Hardware7253/LM3478-Boost-Dev-Board/README.md

# LM3478 Boost Dev Board
A dev board for an LM3478 controlled boost converter

Contains two python calculators for selecting appropriate main components and compensation components

## PCB
PCB
