Hardware7253/LM3478-Boost-Dev-Board/3D/SCDS105R.step

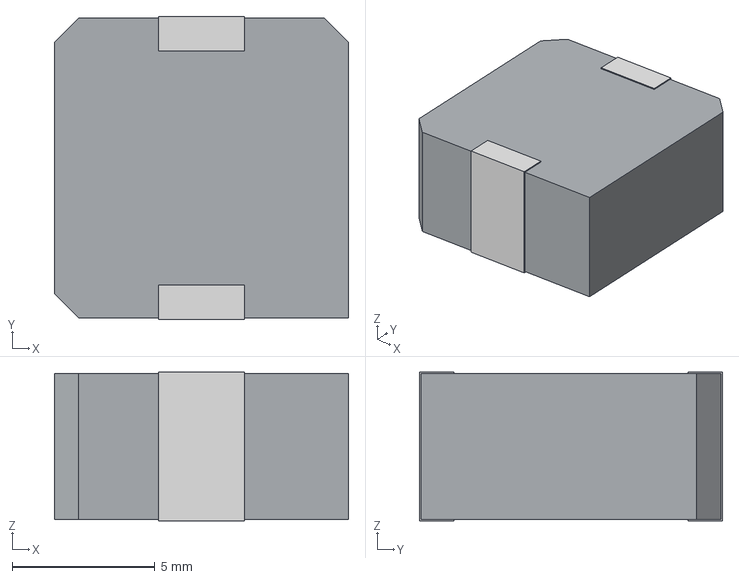
[picture p1: CAD file, 2025-11-23]
3D/SCDS105R.step
10.3 x 10.6 x 5.20 mm
