Hardware7253/LM3478-Boost-Dev-Board/3D/TestPoint_Keystone_5019_Minature.step

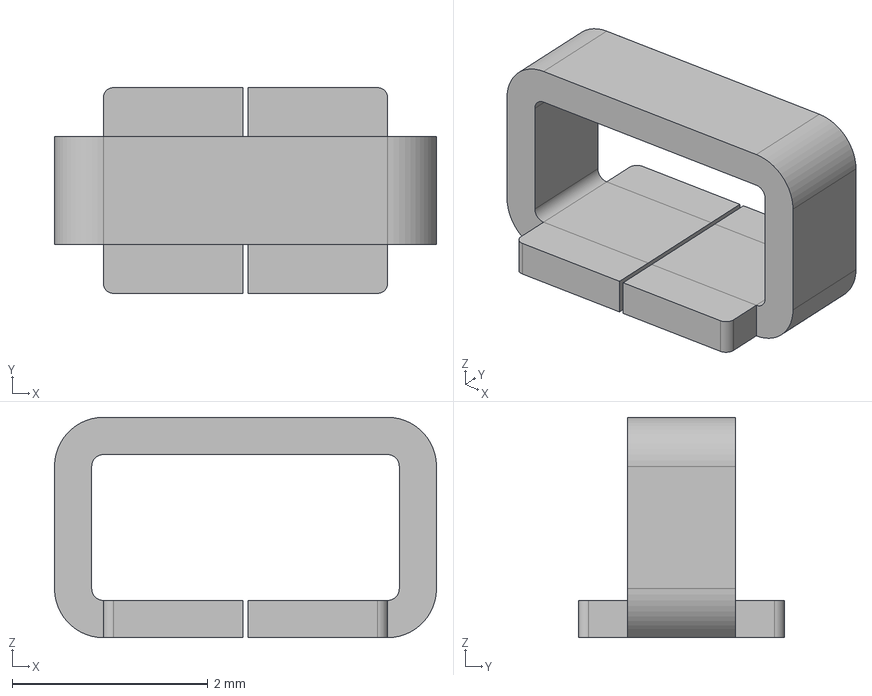
[picture p3: CAD file, 2025-11-23]
3D/TestPoint_Keystone_5019_Minature.step
3.90 x 2.10 x 2.25 mm
