Hardware7253/LM3478-Boost-Dev-Board/boost.kicad_pcb

## KiCad design boost.kicad_pcb (2025-11-28)

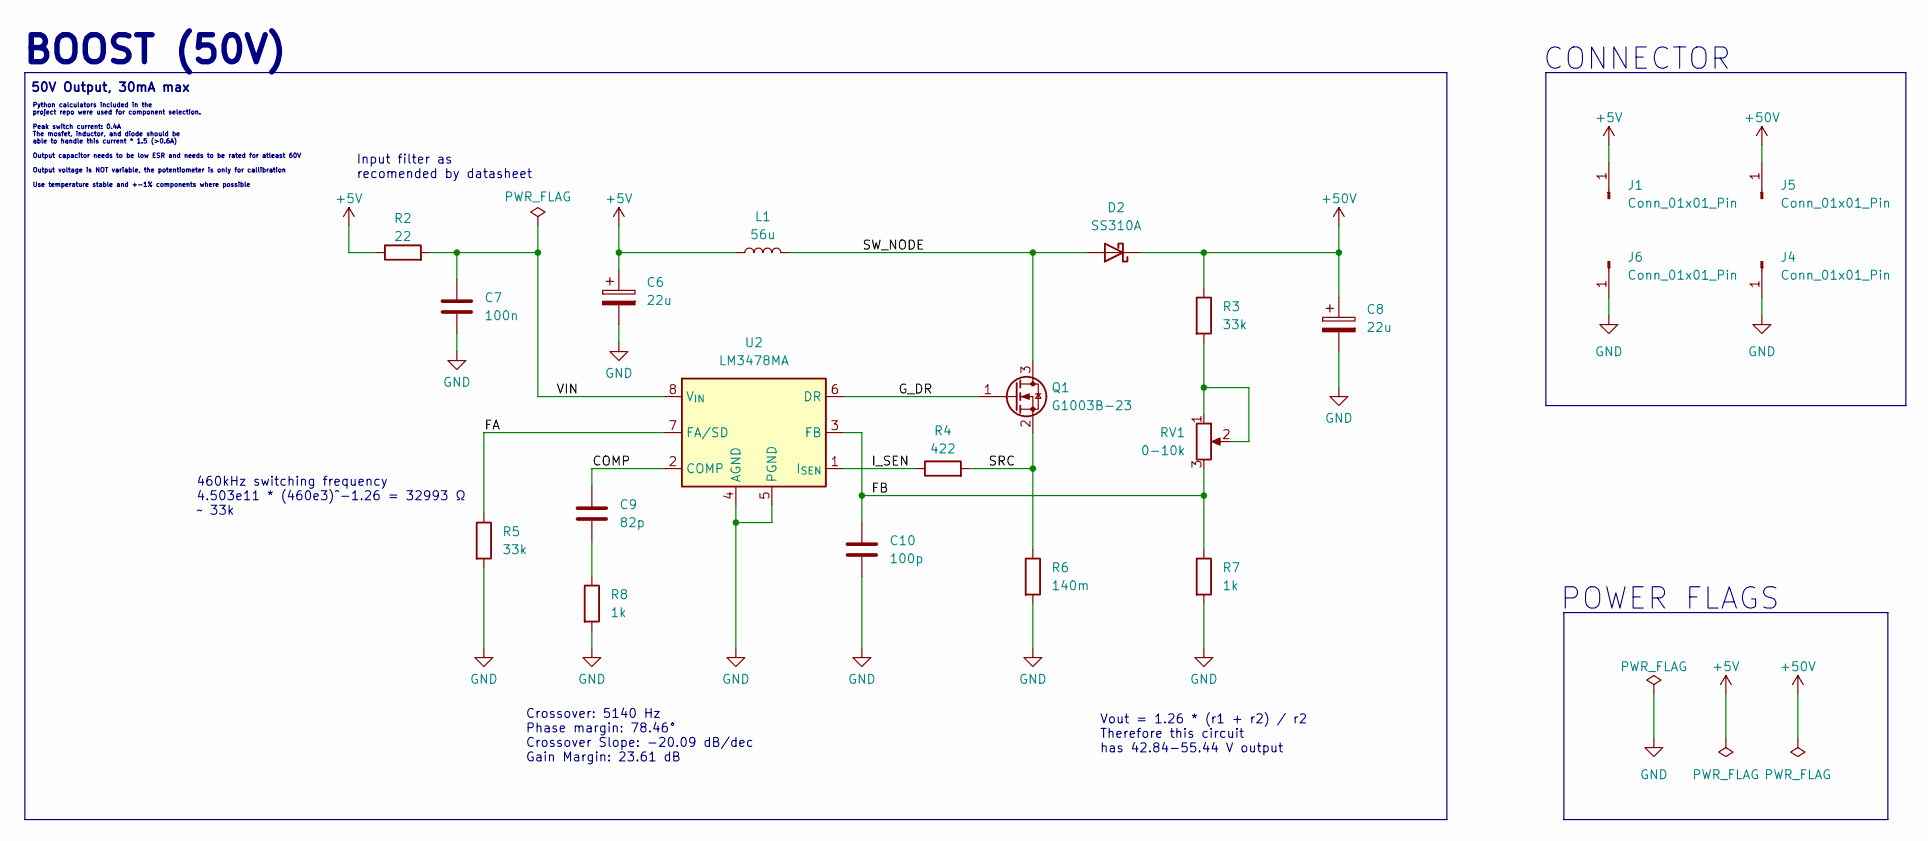
[picture p4: schematic boost.kicad_sch, Boost Converter Dev Board]

Parts:
C6, C8: 22u; CP_Radial_D6.3mm_P2.50mm; LCSC PART # C44606504
C7: 100n; C_0603_1608Metric; LCSC PART # C15725
C9: 82p; C_0603_1608Metric; LCSC PART # C1864236
C10: 100p; C_0603_1608Metric; LCSC PART # C7503509
D2: SS310A; D_SMA; LCSC PART # C48996628
J1, J4, J5, J6: Conn_01x01_Pin; PinHeader_1x01_P2.54mm_Vertical
L1: 56u; Chilisin SCDS105R; LCSC PART # C329728
Q1: G1003B-23; SOT-23-3; LCSC PART # C22362809
R2: 22; R_0603_1608Metric; LCSC PART # C48996824
R3, R5: 33k; R_0603_1608Metric; LCSC PART # C2907028
R4: 422; R_0603_1608Metric; LCSC PART # C5204003
R6: 140m; R_1206_3216Metric; LCSC PART # C37935
R7, R8: 1k; R_0603_1608Metric; LCSC PART # C2907002
RV1: 0-10k; Potentiometer_Bourns_TC33X_Vertical; LCSC PART # C719176
U2: LM3478MA; SOIC-8_3.9x4.9mm_P1.27mm; LCSC PART # C115907

Connections:
+5V: C6.1, J1.1, L1.1, R2.1
+50V: C8.1, D2.1 (K), J5.1, R3.1
/COMP: C9.1, U2.2 (COMP)
/FA: R5.1, U2.7 (FA/SD)
/FB: C10.1, R7.1, RV1.3, U2.3 (FB)
/G_DR: Q1.1 (G), U2.6 (DR)
/I_SEN: R4.1, U2.1 (I_{SEN})
/SRC: Q1.2 (S), R4.2, R6.1
/SW_NODE: D2.2 (A), L1.2, Q1.3 (D)
/VIN: C7.1, R2.2, U2.8 (V_{IN})
GND: C6.2, C7.2, C8.2, C10.2, J4.1, J6.1, R5.2, R6.2, R7.2, R8.2, U2.4 (AGND), U2.5 (PGND)
unnamed: C9.2, R8.1
unnamed: R3.2, RV1.1, RV1.2

Notes on the sheet:
Python calculators included in the project repo were used for component selection. Peak switch current: 0.4A The mosfet, inductor, and diode should be able to handle this current * 1.5 (>0.6A) Output capacitor needs to be low ESR and needs to be rated for atleast 60V Output voltage is NOT variable,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
460kHz switching frequency 4.503e11 * (460e3)^-1.26 = 32993 Ω ~ 33k
BOOST (50V)
Vout = 1.26 * (r1 + r2) / r2 Therefore this circuit has 42.84-55.44 V output
CONNECTOR
Crossover: 5140 Hz Phase margin: 78.46° Crossover Slope: -20.09 dB/dec Gain Margin: 23.61 dB
Input filter as recomended by datasheet
POWER FLAGS
50V Output, 30mA max

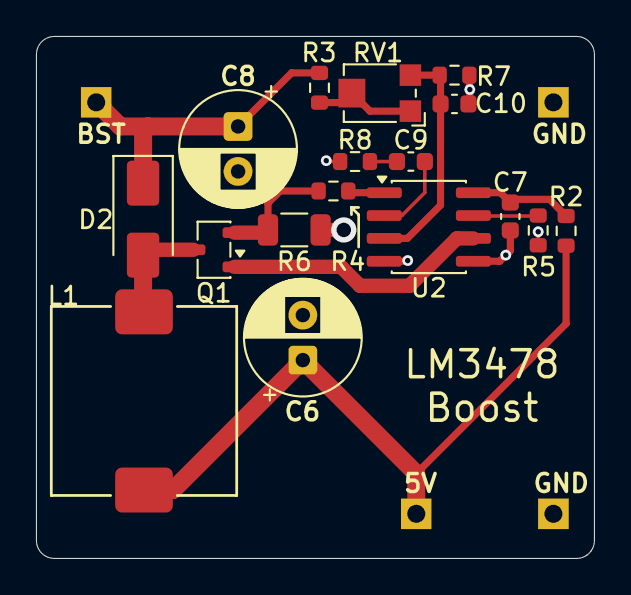
[picture p5: board boost.kicad_pcb from above]

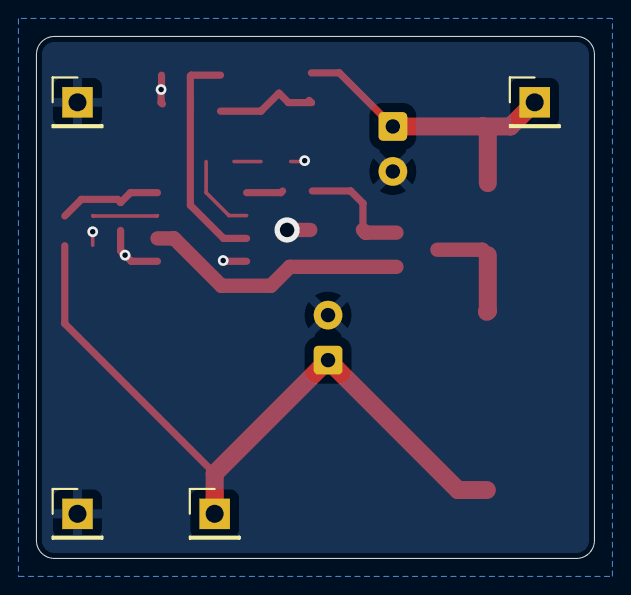
[picture p6: board boost.kicad_pcb from below]

Board: 2 copper layers, 31.0 x 29.0 mm, 21 parts (4 on the bottom side), 13 nets.
