Hardware7253/LM3478-Boost-Dev-Board/(commit log)

2025-11-23 Initial commit
    In the same formfactor as the power supply from OperationUrd.
    The formfactor will change in subsequent commits
    [SCDS105R.step, TC33X-1-103E.stp, TestPoint_Keystone_5019_Minature.step, boost.kicad_pcb, boost.kicad_sch]
2025-11-27 Switched to breadboard formfactor
    Also added files for GH
    [boost.kicad_pcb, boost.kicad_sch, boost_BOM.csv]
2025-11-27 Added calculators
    Changed component values to match calculator recommended values
    [boost.kicad_pcb, boost.kicad_sch]
2025-11-28 Changed to THT cap
    Low ESR THT caps are easier to find. But I'm really changing cause the
    SMD cap I wanted went out of stock :(
    [boost.kicad_pcb, boost.kicad_sch]
2025-12-19 Added efficiency tests to reference design
    [boost.kicad_sch]
